peteham56/picklescore/picklescore/ScadFiles/throatpod_bottom.stl

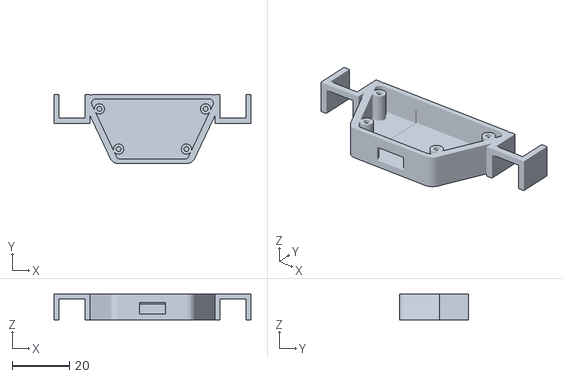
[picture p1: CAD file, 2026-08-20]
picklescore/ScadFiles/throatpod_bottom.stl
68.6 x 24.0 x 9.00
