peteham56/picklescore/picklescore/ScadFiles/throatpod_top.stl

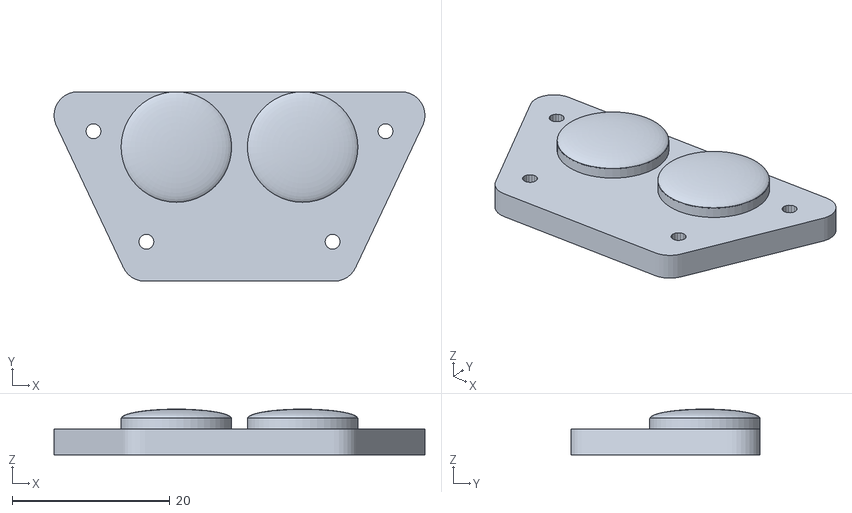
[picture p2: CAD file, 2026-08-20]
picklescore/ScadFiles/throatpod_top.stl
47.0 x 24.0 x 5.80
