peteham56/picklescore/picklescore/ScadFiles/wristband_bottom.stl

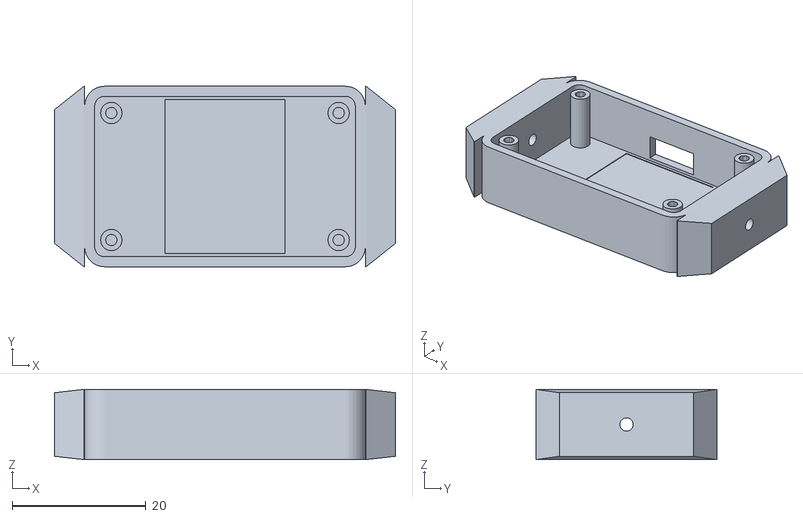
[picture p3: CAD file, 2026-08-03]
picklescore/ScadFiles/wristband_bottom.stl
51.0 x 27.0 x 10.5
