peteham56/picklescore/picklescore/ScadFiles/wristband_top.stl

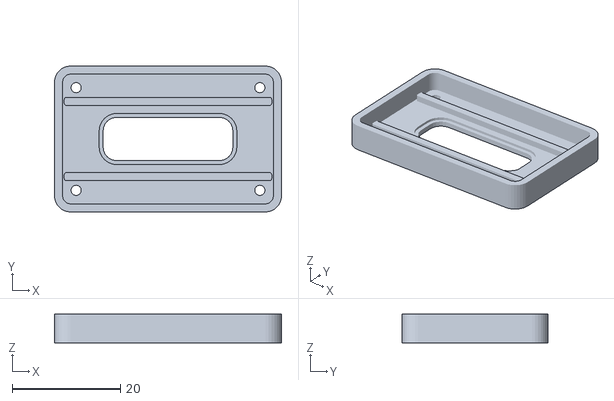
[picture p4: CAD file, 2026-08-03]
picklescore/ScadFiles/wristband_top.stl
42.0 x 27.0 x 5.30
