peteham56/picklescore/(commit log)

2026-05-06 Initial commit — PickleScore v4.0 ThroatPod + v3.0 Wristband
    Firmware, enclosure SCAD files, and assembly guide for both devices.
    Print material set to TPU 95A in SCAD headers and assembly guide.
    [picklscore_throat_pod_v2_1.scad, picklscore_wristband_v2.scad]
2026-05-06 Add re-exported STL files for ThroatPod and Wristband
    All 4 shells re-rendered from current SCAD sources (May 6).
    [throat_pod_bottom.stl, throat_pod_top.stl, wristband_bottom.stl, wristband_top.stl]
2026-05-11 Reorganize all PickleScore files under picklescore/ directory
    [picklscore_throat_pod_v2_1.scad, picklscore_wristband_v2.scad, throat_pod_bottom.stl, throat_pod_top.stl, wristband_bottom.stl, wristband_top.stl]
2026-05-11 Remove Gen 1 Python prototypes and test scripts; add build .gitignore
2026-05-19 Redesign ThroatPod enclosure based on measured JOOLA Perseus geometry
    - pod_h 20→24mm: XIAO long side (21mm) now runs along pod height
    - pod_top_w 34→47mm: measured 65mm paddle width − 2×9mm lips at 24mm height
    - pod_bot_w 28mm confirmed at handle transition
    - clip_gap 7.5→9mm: measured lip width at 24mm height
    - USB-C moved from right side wall to bottom wall — cable exits toward grip, clear of clip arms
    - XIAO pocket swapped: long side along y, short side along x
    - lipo_y centered at 0 (was offset 3mm)
    - All comments and quick-reference block updated to match
    [picklscore_throat_pod_v2_1.scad]
2026-06-11 Fix ThroatPod assembly bugs; redesign Wristband toward Fitbit Inspire 3 style
    ThroatPod (picklscore_throat_pod_v2_1.scad):
    - Remove screw holes through VHB/back face (were punching visible holes in paddle-facing surface)
    - Add 4 screw clearance holes to top_shell() button face — screws now enter from button side
    - Increase boss_h 3.0→7.5mm so bosses reach near parting plane; M1.6×6mm screws work
    - Reduce pad_depth 0.8→0.4mm to eliminate fiber bleed-through on back face
    - Increase floor_t 1.2→1.5mm for more solid back face (1.1mm remaining under VHB recess)
    Wristband (picklscore_wristband_v2.scad):
    - Reduce slim profile body 48×24×13mm → 42×22×12.5mm (closer to Fitbit Inspire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
    [picklscore_throat_pod_v2_1.scad, picklscore_wristband_v2.scad]
2026-07-20 Fix ThroatPod top shell: button bosses eaten by interior hollow, switch cavity unbuildable
    - top_shell(): interior hollow was subtracted from the union that included
    the button bosses, so it carved away nearly all of each boss wherever it
    sat over the (non-rim) interior area — only the sliver overlapping the
    solid perimeter rim survived. Restructured so the hollow only cuts the
    tapered body; bosses are unioned in afterward, out of its reach.
    - Replaced the single blind membrane cut with a counterbore: a narrow wire
    bore open to the interior (parting line) plus a switch-sized bore under
    the membrane, separated by a shoulder. The old cut was sealed on both
    ends, which made the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
    [picklscore_throat_pod_v2_1.scad]
2026-08-02 Fix Wristband OLED I2C pin swap, add OLED auto-sleep on idle
    - oled_test.ino had SDA/SCL backwards (7/6) vs. the main firmware's
    correct 6/7 (D4/D5 on XIAO ESP32-C3); fixed for future debugging use.
    - PickleScore_Wristband.ino: OLED sleeps after 3 min with no real
    score/serve change (tracked via a real_change flag, since the
    ThroatPod advertises continuously even when nothing changes) and
    wakes instantly on the next genuine score/undo/reset. BLE scanning
    itself is unaffected — only the display panel sleeps.
    Claude-Session: https://claude.ai/code/session_0198siYmhu8hfVQyQwVZKrq4
    [PickleScore_Wristband.ino, oled_test.ino]
2026-08-03 Fix Wristband screw bosses, stack-height, and USB-C fit; widen to 27mm
    Screws couldn't reach: boss_h was a fixed 3.0mm against a 9.0mm bottom
    shell, leaving a 4.8mm dead-air gap. Now derived from bot_h so it always
    reaches the parting line.
    Physical dry-fit measurements showed the real chip+LiPo+OLED stack
    (12.5mm) and OLED module (3.54mm) both exceeded the SCAD's budget
    (9.5mm / 2.0mm), causing a vertical bulge. esp_thk, matrix_thk, bot_h,
    and top_h increased to match.
    XIAO board's USB-C connector (22.39mm incl. overhang) couldn't reach
    either wall in its original along-arm orientation without conflicting
    with the integrated spring-bar lug caps at both ends. Board rotated 90°
    so its leng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
    [picklscore_wristband_v2.scad, wristband_bottom.stl, wristband_top.stl]
2026-08-03 Add missing OLED PCB retaining rails to Wristband top shell
    The assembly guide has always described "pressing the OLED into a
    38x12mm pocket," but top_shell() never actually cut one -- matrix_w/
    matrix_h were only ever used in the assembly() preview cube, never as a
    real feature. Without it, the OLED PCB had nothing to register against
    inside the top shell (especially now that body_wid grew to 27mm) and
    could drift sideways enough to misalign the active area with the window.
    Added two rails flanking the window on the across-wrist (Y) sides only
    -- the along-arm (X) direction is already snug (38mm PCB in a 39mm
    interior, ~0.5mm/side), so a full 4-sided frame doesn't fit there.
    Co-Authored-B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
    [picklscore_wristband_v2.scad, wristband_bottom.stl, wristband_top.stl]
2026-08-03 Update Wristband assembly guide for August 2026 fit fixes
    Guide previously described the pre-fix dimensions (21.5x18x4mm XIAO
    pocket, 38x12mm OLED "pocket" that never existed in the SCAD, no
    mention of the required 90-degree board rotation). Updated to match
    picklscore_wristband_v2.scad as of commits 165c397/5829cb3: XIAO pocket
    now 18x23x5.5mm with the long/USB-C edge across the wrist, OLED seats
    between two retaining rails rather than a full pocket, and a note that
    the body grew to 42x27x15.8mm. Screw spec (M1.6x5mm) is unchanged.
    Claude-Session: https://claude.ai/code/session_01124ssPEnb7wYiDzMd3d1JY
2026-08-03 Add regenerated Wristband assembly guide PDF (August 2026 fit fixes)
    Regenerated from PickleScore/wristband_assembly_print.html (commit
    6a35260) via headless Chromium print-to-pdf. This PDF was previously
    untracked/out of date with the June 2026 dimensions; this is its first
    commit to the repo.
    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
2026-08-03 Commit ThroatPod switch-cavity and shell fixes from 2026-07-30 session
    These fixes were made and STL-verified in an earlier session but never
    committed. Diagnosed from the first Craftcloud reprint (rigid + switches
    wouldn't fit):
    1. Switch cavity was a plain r=5.0mm round bore, sized only to the TS40's
    6x6mm body. Actual solderable footprint (gull-wing legs) is 10.0x5.6mm
    and clipped the bore by ~0.8mm. Replaced with a stadium shape (hull of
    two r=3.1mm circles); btn_boss_r bumped 6.5->7.0mm to keep wall margin
    around the bigger cavity.
    2. Counterbore was backwards: the only accessible opening (interior face)
    was a narrow r=2.5mm wire bore, while the switch-sized pocket was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
    [picklscore_throat_pod_v2_1.scad, throat_pod_bottom.stl, throat_pod_top.stl, throatpod_bottom.stl, throatpod_top.stl]
2026-08-20 Fix ThroatPod lower screw-boss/XIAO collision; update wristband screw length
    ThroatPod: lower screw bosses sat at x=±9mm, exactly the edge of the
    18mm-wide XIAO pocket (zero clearance) — inserting the board flexed the
    boss and misaligned the lower screw holes vs. the top shell. Widened
    pod_bot_w 28→30mm and gave the bottom row its own inset
    (boss_inset_x_bot=3.2mm) so the bosses sit clear of the board. Both
    shells re-rendered clean; throatpod_top.stl/throatpod_bottom.stl
    re-exported.
    Wristband: M1.6×5/6mm screws proved too short in practice despite
    boss_h having plenty of depth on paper — updated BOM/reference comment
    to M1.6×8mm for real engagement margin. No geometry change neede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
    [picklscore_throat_pod_v2_1.scad, picklscore_wristband_v2.scad, throatpod_bottom.stl, throatpod_top.stl]
2026-08-20 Correct wristband screw-length recommendation to M1.6x10mm
    Previous commit's M1.6x8mm guess only accounted for wall_t (1.5mm)
    between the screw entry and the boss. Actually traced the geometry:
    the screw clearance hole's (x,y) sits over the hollow OLED cavity, not
    solid wall, so the shank has to cross the full top_h (5.3mm) as dead
    travel before reaching the boss at all. 10mm gives ~4.7mm real thread
    engagement instead of 8mm's ~2.7mm.
    Claude-Session: https://claude.ai/code/session_013JTXhVwGPJSufG3e2ZkwY3
    [picklscore_wristband_v2.scad]
